Handkep/LEDController/KiCad/plots/LEDController__Assembly.pdf

1 | 2 | 3 | 4 | 5 | 6

A

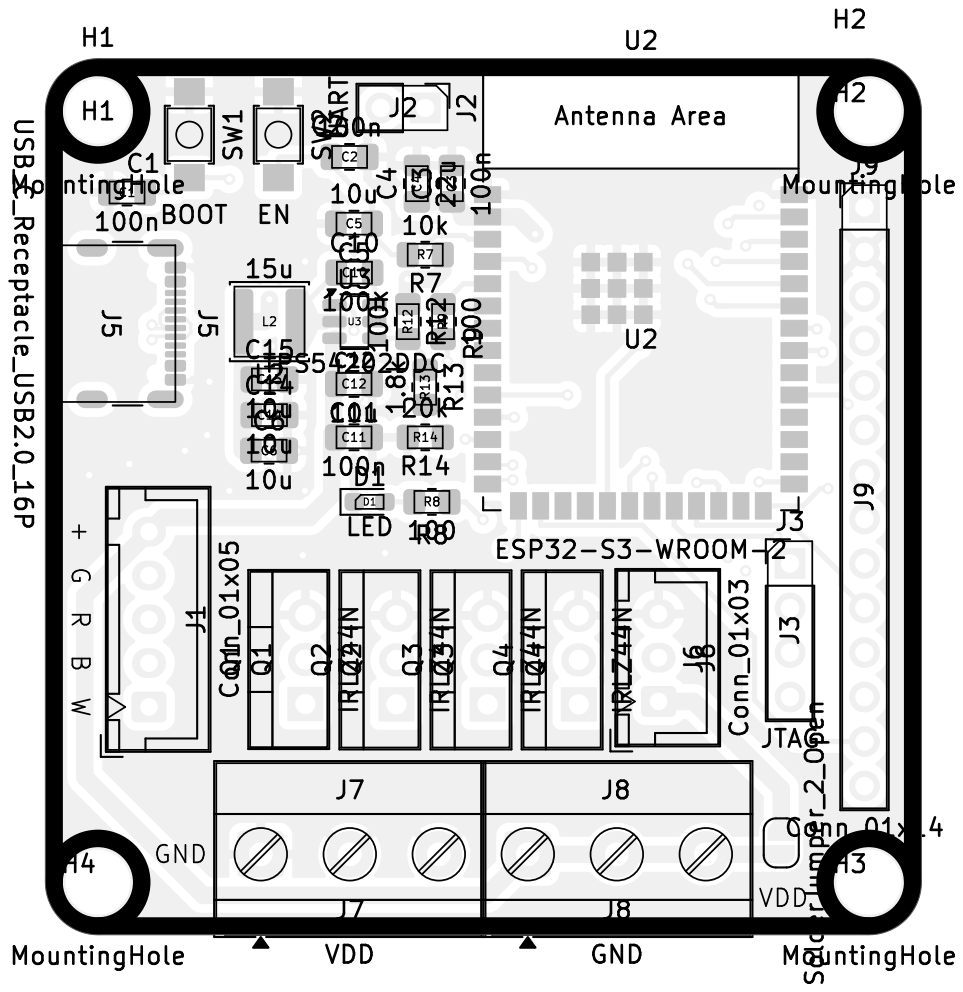
[picture p1: page 1]

A

A

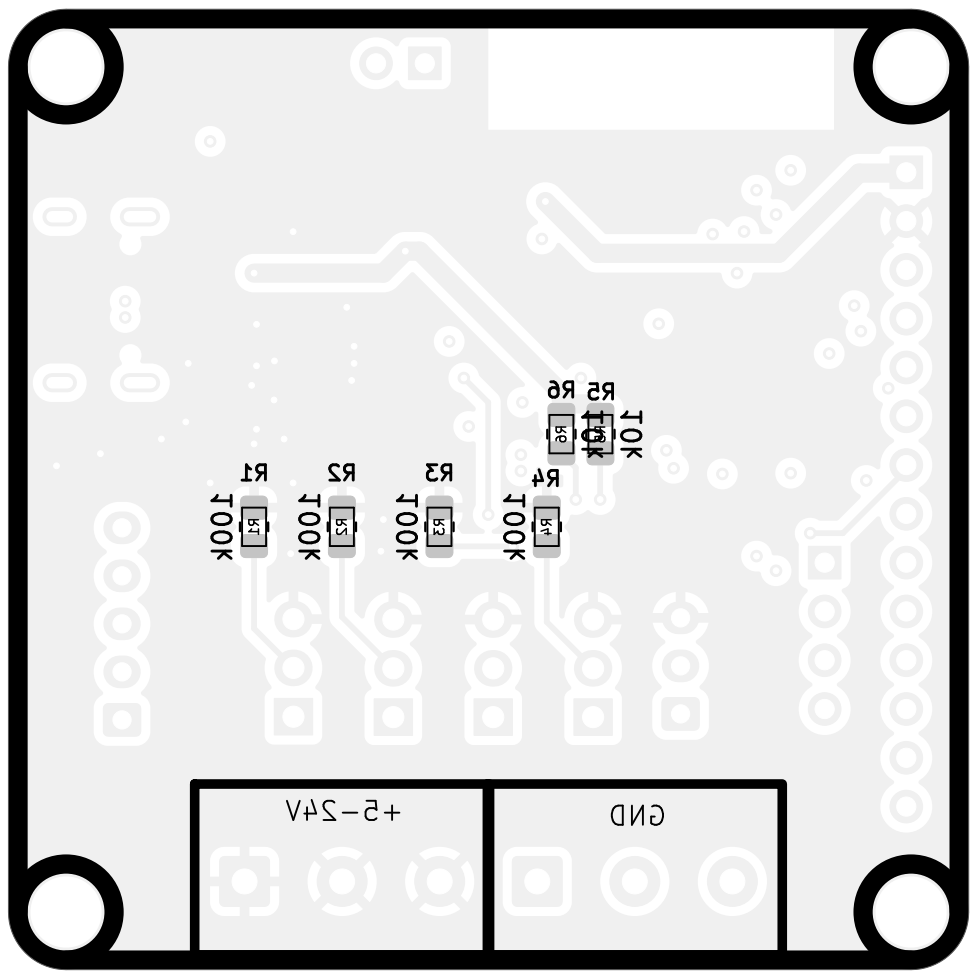
[picture p2: page 2]
D Date: 2025-05-27 KiCad; E.D.A. 9.0.2 Size: A4; Rev: 1; Id: /1 Title: LED Controller File: LEDController.kicad_pcb Sheet: Black; And; White; BOT Paulus; Handke Board2Pdf:; Black; BOT -; Page 2/6 ¹⁰kR5 100k

A

A

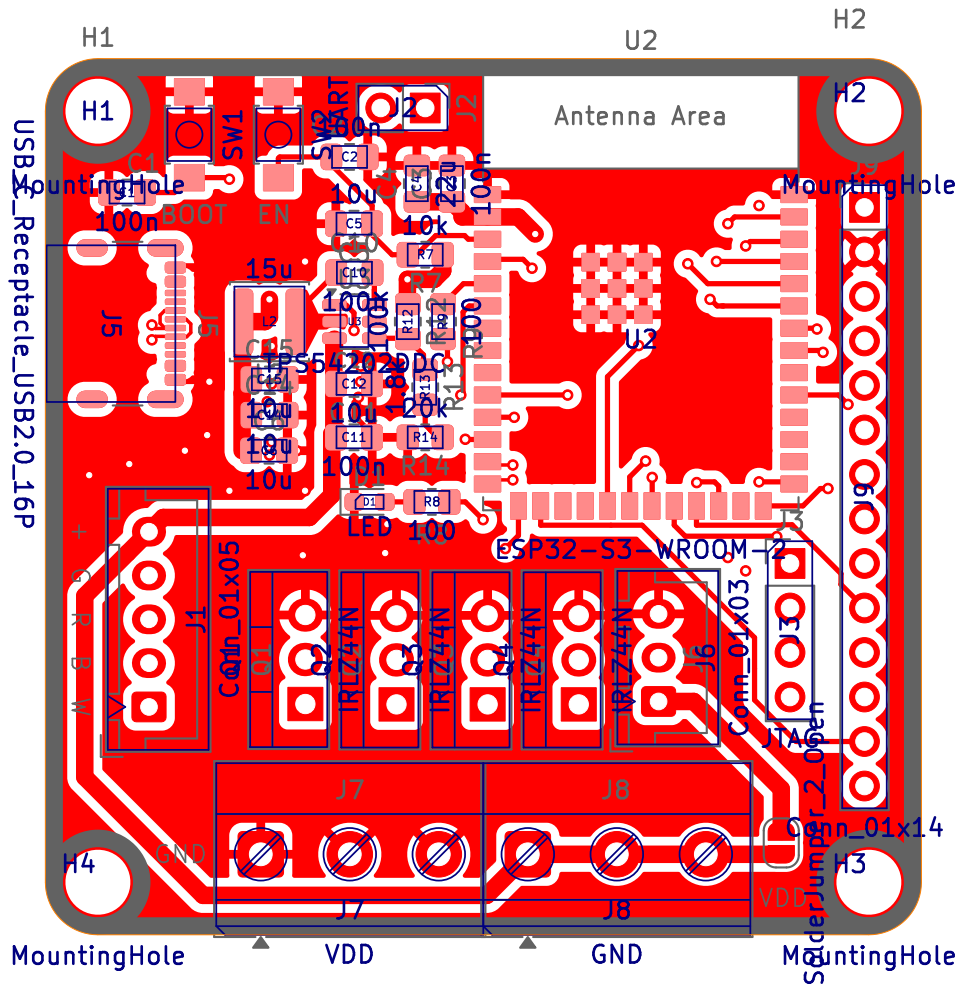
[picture p3: page 3]

A

A

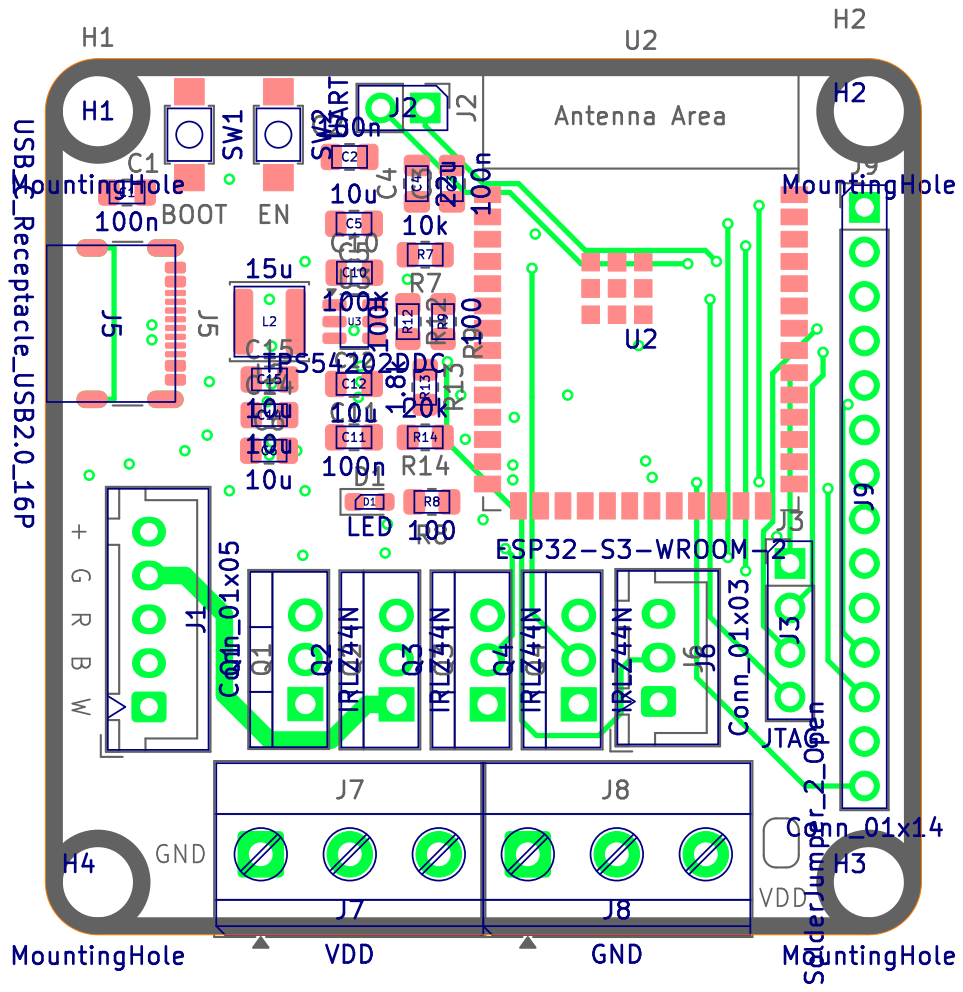
[picture p4: page 4]

A

A

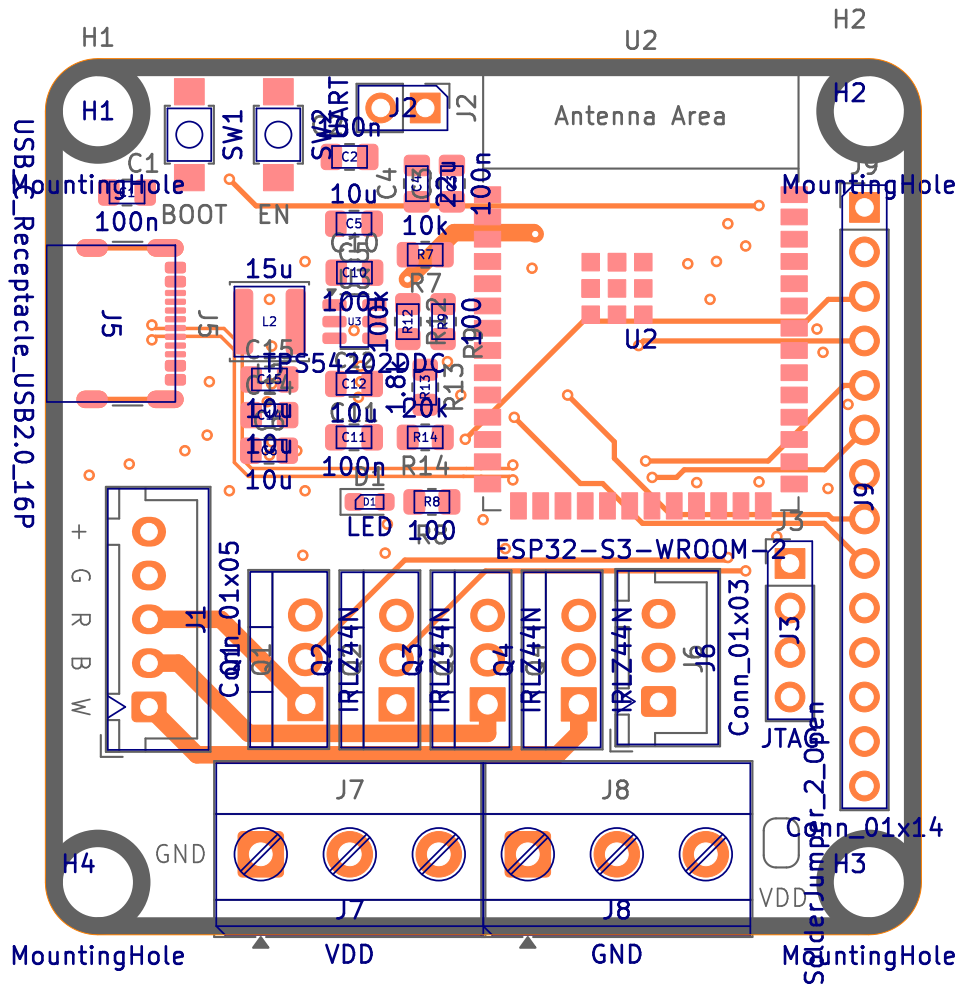
[picture p5: page 5]

A

A

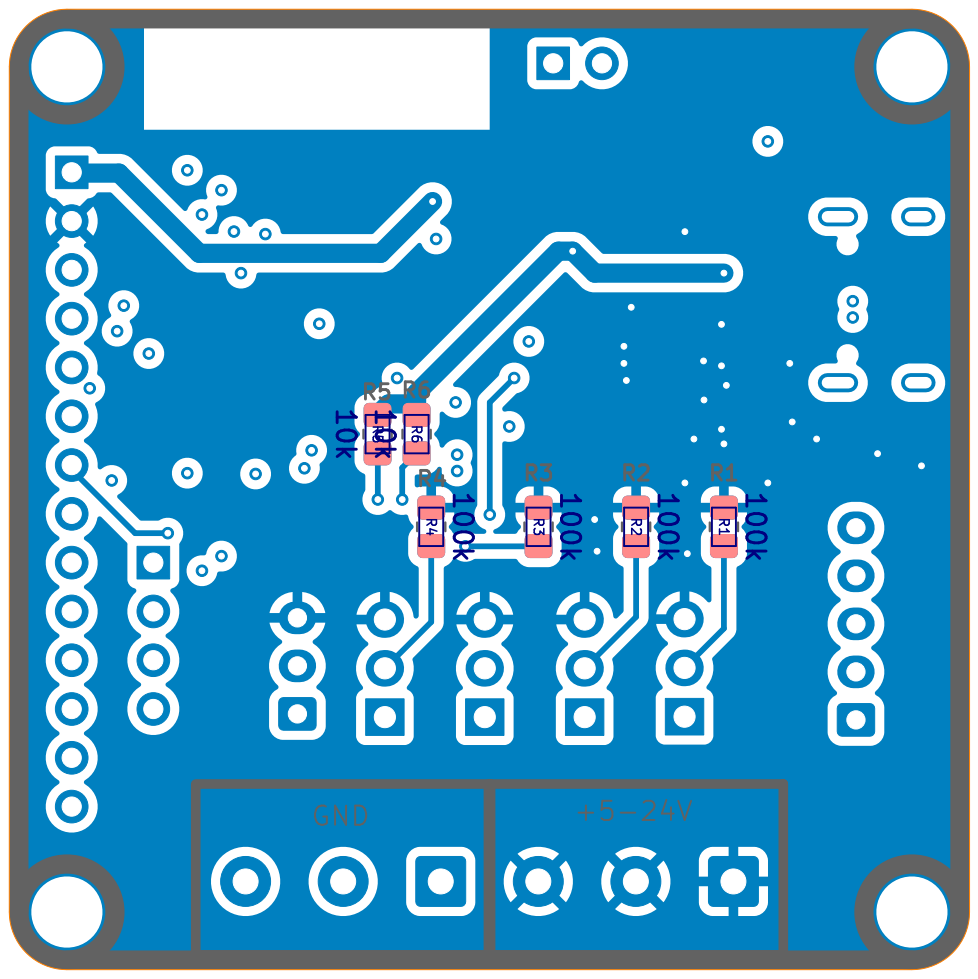
[picture p6: page 6]
GND; D Date: 2025-05-27 KiCad; E.D.A. 9.0.2 Size: A4; Rev: 1; Id: /1 Title: LED Controller File: LEDController.kicad_pcb Sheet: Colored; BOT Paulus; Handke Board2Pdf:; Colored; BOT -; Page 6/6 ¹⁰k
