Handkep/LEDController/KiCad/LEDController.pdf

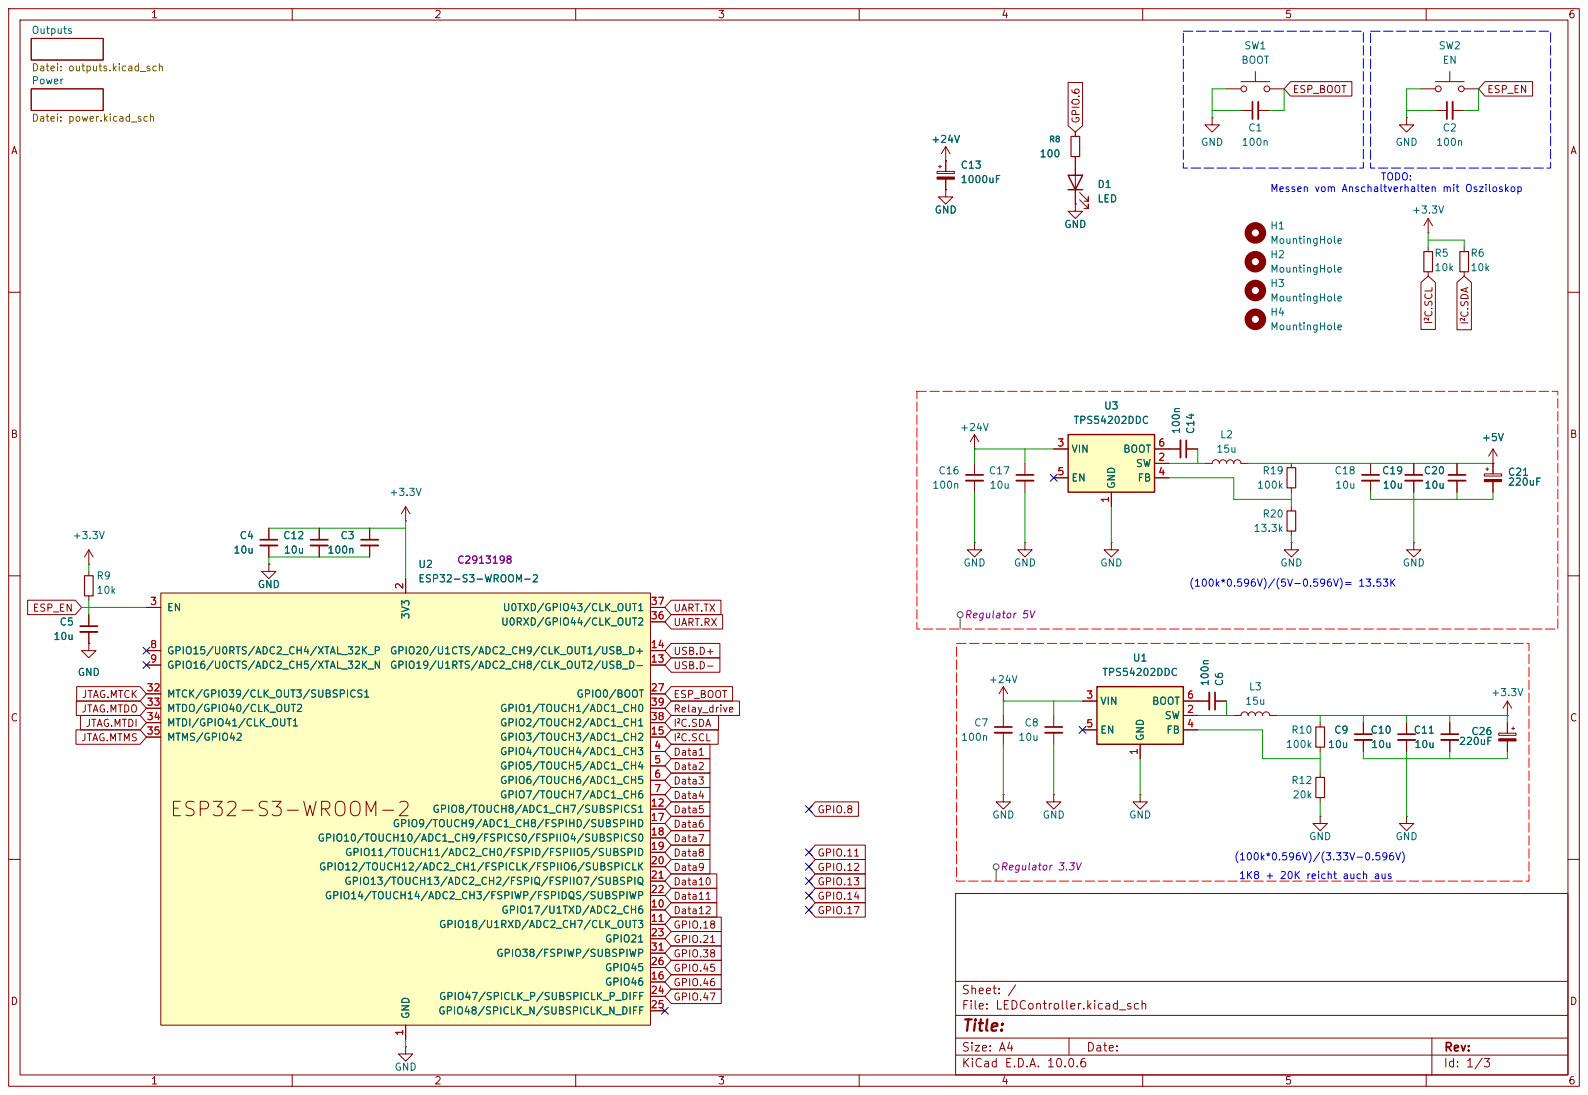
[picture p7: page 1]

TODO: Messen vom Anschaltverhalten mit Osziloskop

I2C.SDA GPIO.47 GPIO.45 GPIO.38 GPIO.46 GPIO.21 GPIO.18 UART.RX USB.D+

JTAG.MTDI JTAG.MTDO

Size: A4 | Rev:
KiCad E.D.A. 10.0.6 | Id: 1/3

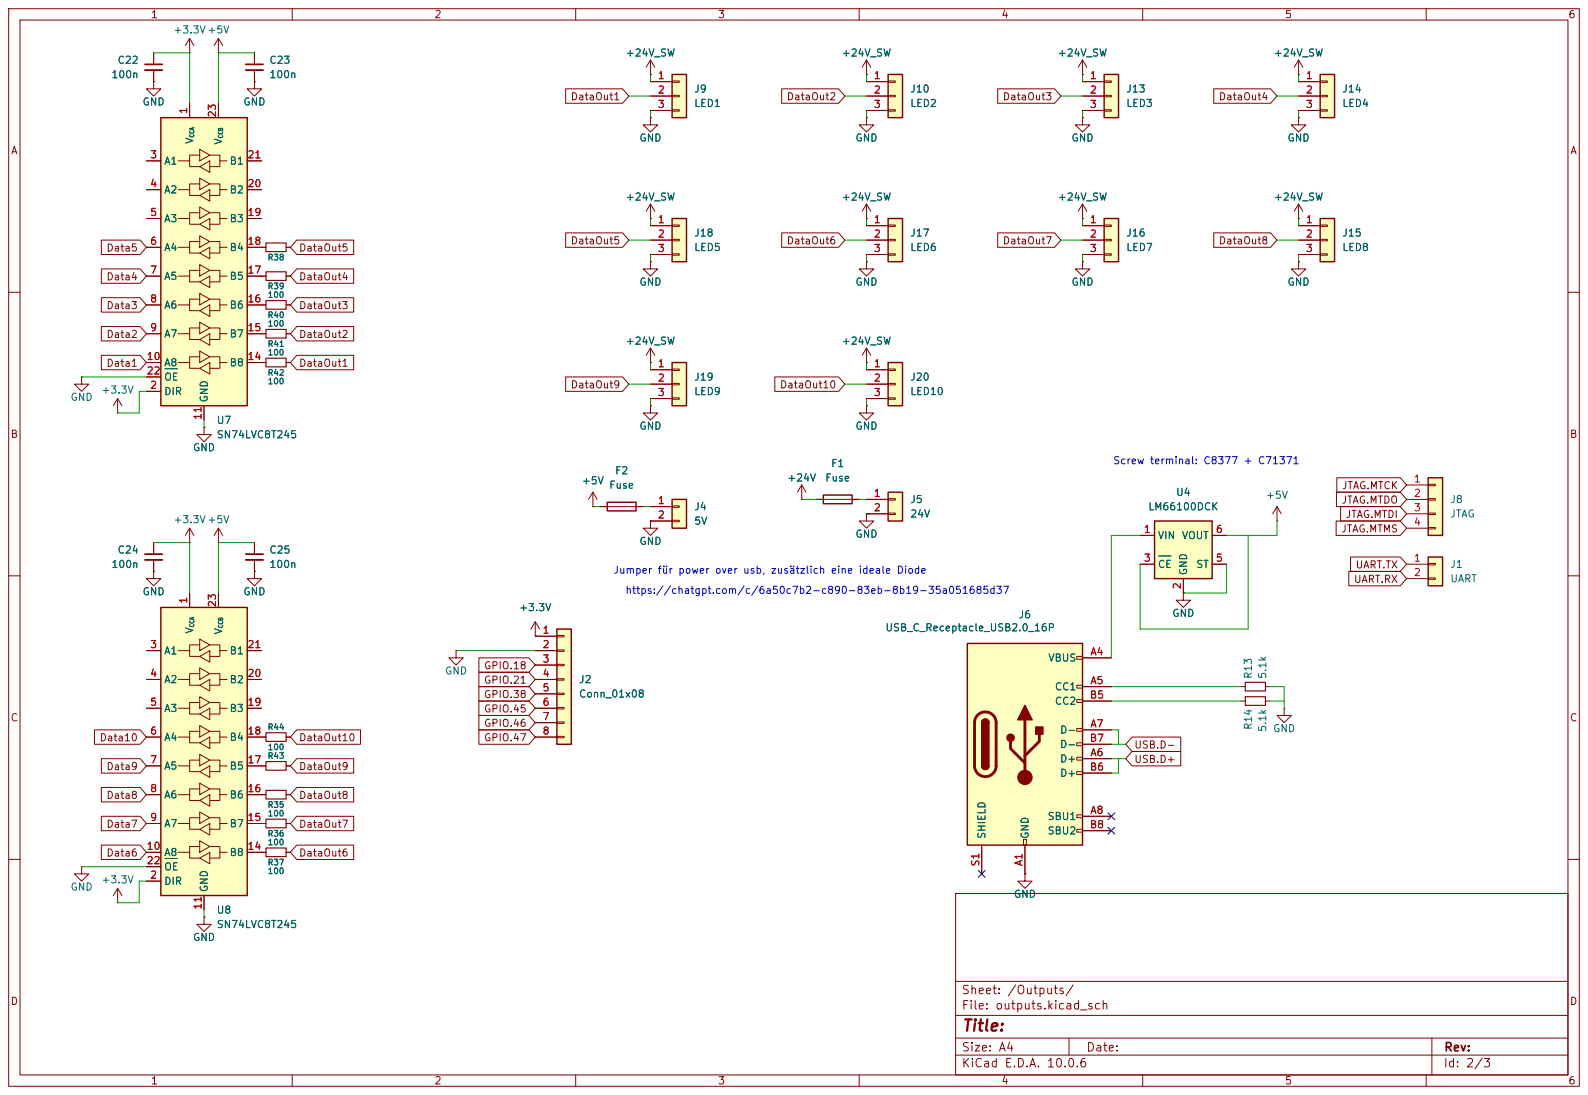
[picture p8: page 2]

JTAG.MTCK
JTAG.MTDO
JTAG.MTDI UART.TX

Jumper für power over usb, zusätzlich eine ideale Diode https://chatgpt.com/c/6a50c7b2-c890-83eb-8b19-35a051685d37

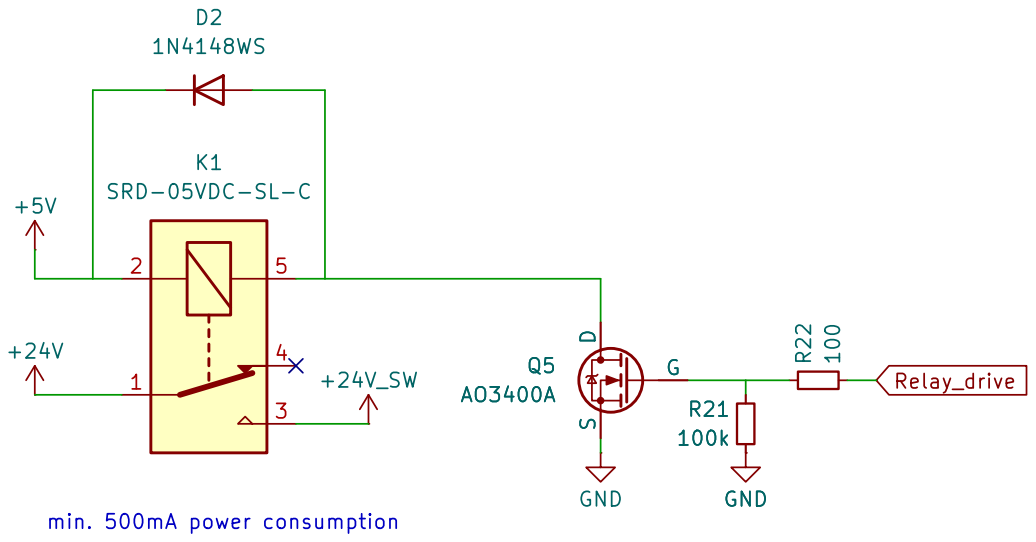
[picture p9: page 3]
