Handkep/LEDController/KiCad/LEDController.kicad_pcb

## KiCad design KiCad/LEDController.kicad_pcb (2026-10-28)

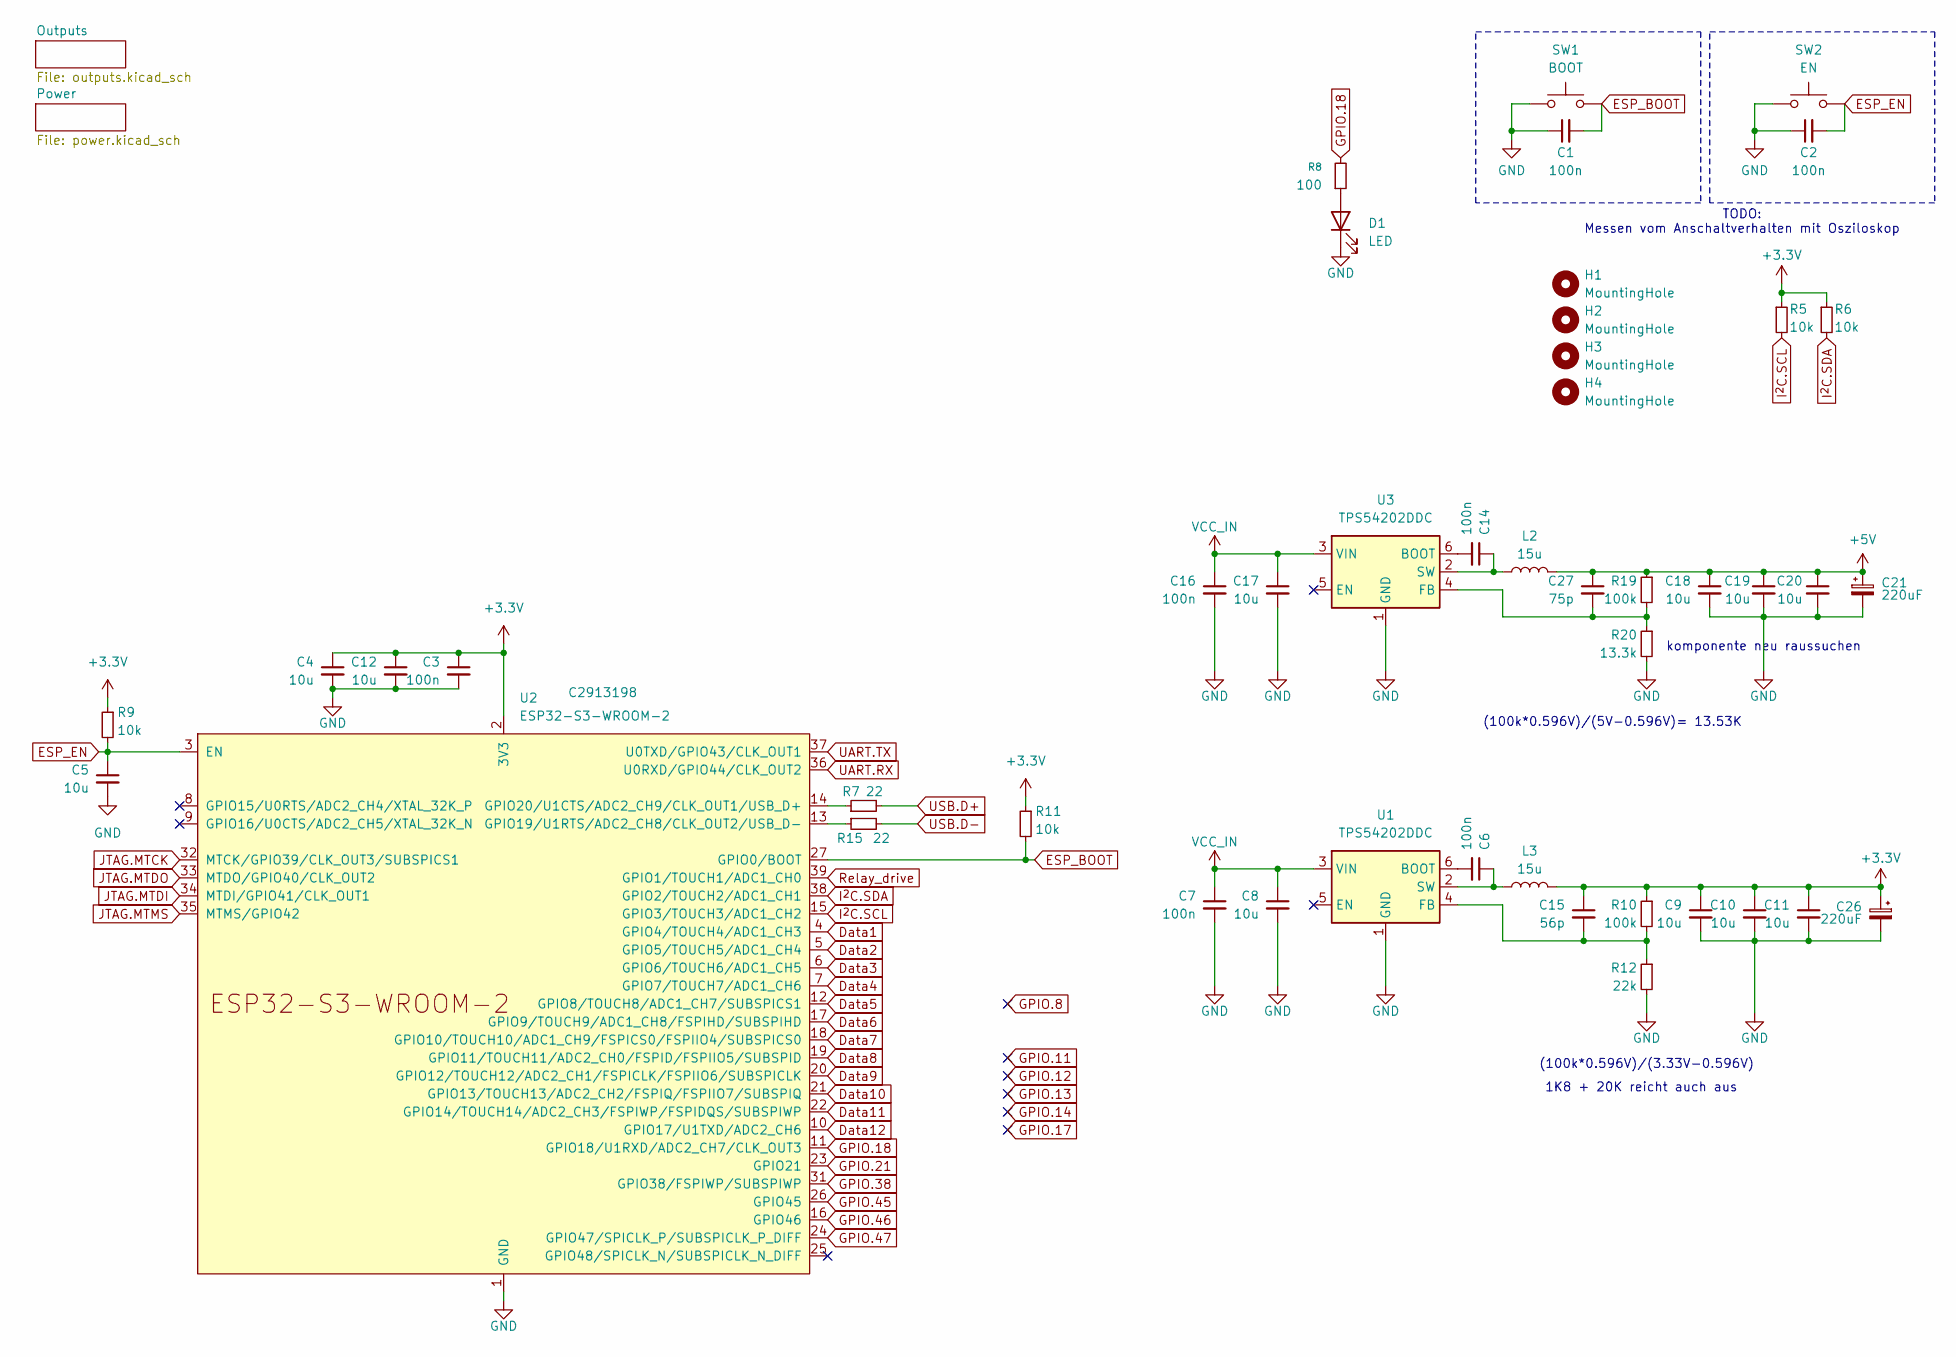
[picture p10: schematic LEDController.kicad_sch]

Parts:
C1, C2, C3, C6, C7, C14, C16: 100n; C_0805_2012Metric_Pad1.18x1.45mm_HandSolder; LCSC C5137467
C4, C5, C8, C9, C10, C11, C12, C17, C18, C19, C20: 10u; C_0805_2012Metric_Pad1.18x1.45mm_HandSolder; LCSC C33546007
C15: 56p; C_0805_2012Metric_Pad1.18x1.45mm_HandSolder
C21, C26: 220uF; CP_Radial_D8.0mm_P3.50mm; LCSC C107639
C27: 75p; C_0805_2012Metric_Pad1.18x1.45mm_HandSolder
D1: LED; LED_0603_1608Metric_Pad1.05x0.95mm_HandSolder; LCSC C7496818
H1, H2, H3, H4: MountingHole; MountingHole_3.2mm_M3
L2, L3: 15u; L_APV_APH0630; LCSC C5349699
R5, R6, R9, R11: 10k; R_0805_2012Metric_Pad1.20x1.40mm_HandSolder; LCSC C2930231
R7, R15: 22; R_0805_2012Metric_Pad1.20x1.40mm_HandSolder
R8: 100; R_0805_2012Metric_Pad1.20x1.40mm_HandSolder; LCSC C2907294
R10, R19: 100k; R_0805_2012Metric_Pad1.20x1.40mm_HandSolder; LCSC C3017875
R12: 22k; R_0805_2012Metric_Pad1.20x1.40mm_HandSolder; LCSC C2907015
R20: 13.3k; R_0805_2012Metric_Pad1.20x1.40mm_HandSolder; LCSC C3017875
SW1: BOOT; SHOU HAN TS342A2P-WZ; LCSC C557591
SW2: EN; SHOU HAN TS342A2P-WZ; LCSC C557591
U1, U3: TPS54202DDC; SOT-23-6; LCSC C191884
U2: ESP32-S3-WROOM-2; LCSC C2913198

Connections:
+3.3V: C3.1, C4.1, C9.1, C10.1, C11.1, C12.1, C15.1, C26.1, L3.2, R5.1, R6.1, R9.1, R10.1, R11.1, U2.2 (3V3); also elsewhere on the board
+5V: C18.1, C19.1, C20.1, C21.1, C27.1, L2.2, R19.1; also elsewhere on the board
Data1: U2.4 (GPIO4/TOUCH4/ADC1_CH3); also elsewhere on the board
Data2: U2.5 (GPIO5/TOUCH5/ADC1_CH4); also elsewhere on the board
Data3: U2.6 (GPIO6/TOUCH6/ADC1_CH5); also elsewhere on the board
Data4: U2.7 (GPIO7/TOUCH7/ADC1_CH6); also elsewhere on the board
Data5: U2.12 (GPIO8/TOUCH8/ADC1_CH7/SUBSPICS1); also elsewhere on the board
Data6: U2.17 (GPIO9/TOUCH9/ADC1_CH8/FSPIHD/SUBSPIHD); also elsewhere on the board
Data7: U2.18 (GPIO10/TOUCH10/ADC1_CH9/FSPICS0/FSPIIO4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); also elsewhere on the board
Data8: U2.19 (GPIO11/TOUCH11/ADC2_CH0/FSPID/FSPIIO5/S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); also elsewhere on the board
Data9: U2.20 (GPIO12/TOUCH12/ADC2_CH1/FSPICLK/FSPIIO6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); also elsewhere on the board
Data10: U2.21 (GPIO13/TOUCH13/ADC2_CH2/FSPIQ/FSPIIO7/S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); also elsewhere on the board
Data11: U2.22 (GPIO14/TOUCH14/ADC2_CH3/FSPIWP/FSPIDQS/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)
Data12: U2.10 (GPIO17/U1TXD/ADC2_CH6)
ESP_BOOT: C1.2, R11.2, SW1.2, U2.27 (GPIO0/BOOT)
ESP_EN: C2.2, C5.1, R9.2, SW2.2, U2.3 (EN)
GND: C1.1, C2.1, C3.2, C4.2, C5.2, C7.2, C8.2, C9.2, C10.2, C11.2, C12.2, C16.2, C17.2, C18.2, C19.2, C20.2, C21.2, C26.2, D1.1 (K), R12.2, R20.2, SW1.1, SW2.1, U1.1 (GND), U2.1 (GND), U2.40 (GND), U2.41 (GND), U3.1 (GND); also elsewhere on the board
GPIO.18: R8.2, U2.11 (GPIO18/U1RXD/ADC2_CH7/CLK_OUT3); also elsewhere on the board
GPIO.21: U2.23 (GPIO21); also elsewhere on the board
GPIO.38: U2.31 (GPIO38/FSPIWP/SUBSPIWP); also elsewhere on the board
GPIO.45: U2.26 (GPIO45); also elsewhere on the board
GPIO.46: U2.16 (GPIO46); also elsewhere on the board
GPIO.47: U2.24 (GPIO47/SPICLK_P/SUBSPICLK_P_DIFF); also elsewhere on the board
I^{2}C.SCL: R5.2, U2.15 (GPIO3/TOUCH3/ADC1_CH2)
I^{2}C.SDA: R6.2, U2.38 (GPIO2/TOUCH2/ADC1_CH1)
JTAG.MTCK: U2.32 (MTCK/GPIO39/CLK_OUT3/SUBSPICS1); also elsewhere on the board
JTAG.MTDI: U2.34 (MTDI/GPIO41/CLK_OUT1); also elsewhere on the board
JTAG.MTDO: U2.33 (MTDO/GPIO40/CLK_OUT2); also elsewhere on the board
JTAG.MTMS: U2.35 (MTMS/GPIO42); also elsewhere on the board
unnamed: D1.2 (A), R8.1
unnamed: C6.2, U1.6 (BOOT)
unnamed: C15.2, R10.2, R12.1, U1.4 (FB)
unnamed: C6.1, L3.1, U1.2 (SW)
unnamed: R15.1, U2.13 (GPIO19/U1RTS/ADC2_CH8/CLK_OUT2/USB_D-)
unnamed: R7.1, U2.14 (GPIO20/U1CTS/ADC2_CH9/CLK_OUT1/USB_D+)
unnamed: C14.2, U3.6 (BOOT)
unnamed: C27.2, R19.2, R20.1, U3.4 (FB)
unnamed: C14.1, L2.1, U3.2 (SW)
Relay_drive: U2.39 (GPIO1/TOUCH1/ADC1_CH0); also elsewhere on the board
UART.RX: U2.36 (U0RXD/GPIO44/CLK_OUT2); also elsewhere on the board
UART.TX: U2.37 (U0TXD/GPIO43/CLK_OUT1); also elsewhere on the board
USB.D+: R7.2; also elsewhere on the board
USB.D-: R15.2; also elsewhere on the board
VCC_IN: C7.1, C8.1, C16.1, C17.1, U1.3 (VIN), U3.3 (VIN); also elsewhere on the board

Notes on the sheet:
(100k*0.596V)/(5V-0.596V)= 13.53K
komponente neu raussuchen
(100k*0.596V)/(3.33V-0.596V)
1K8 + 20K reicht auch aus
TODO: Messen vom Anschaltverhalten mit Osziloskop

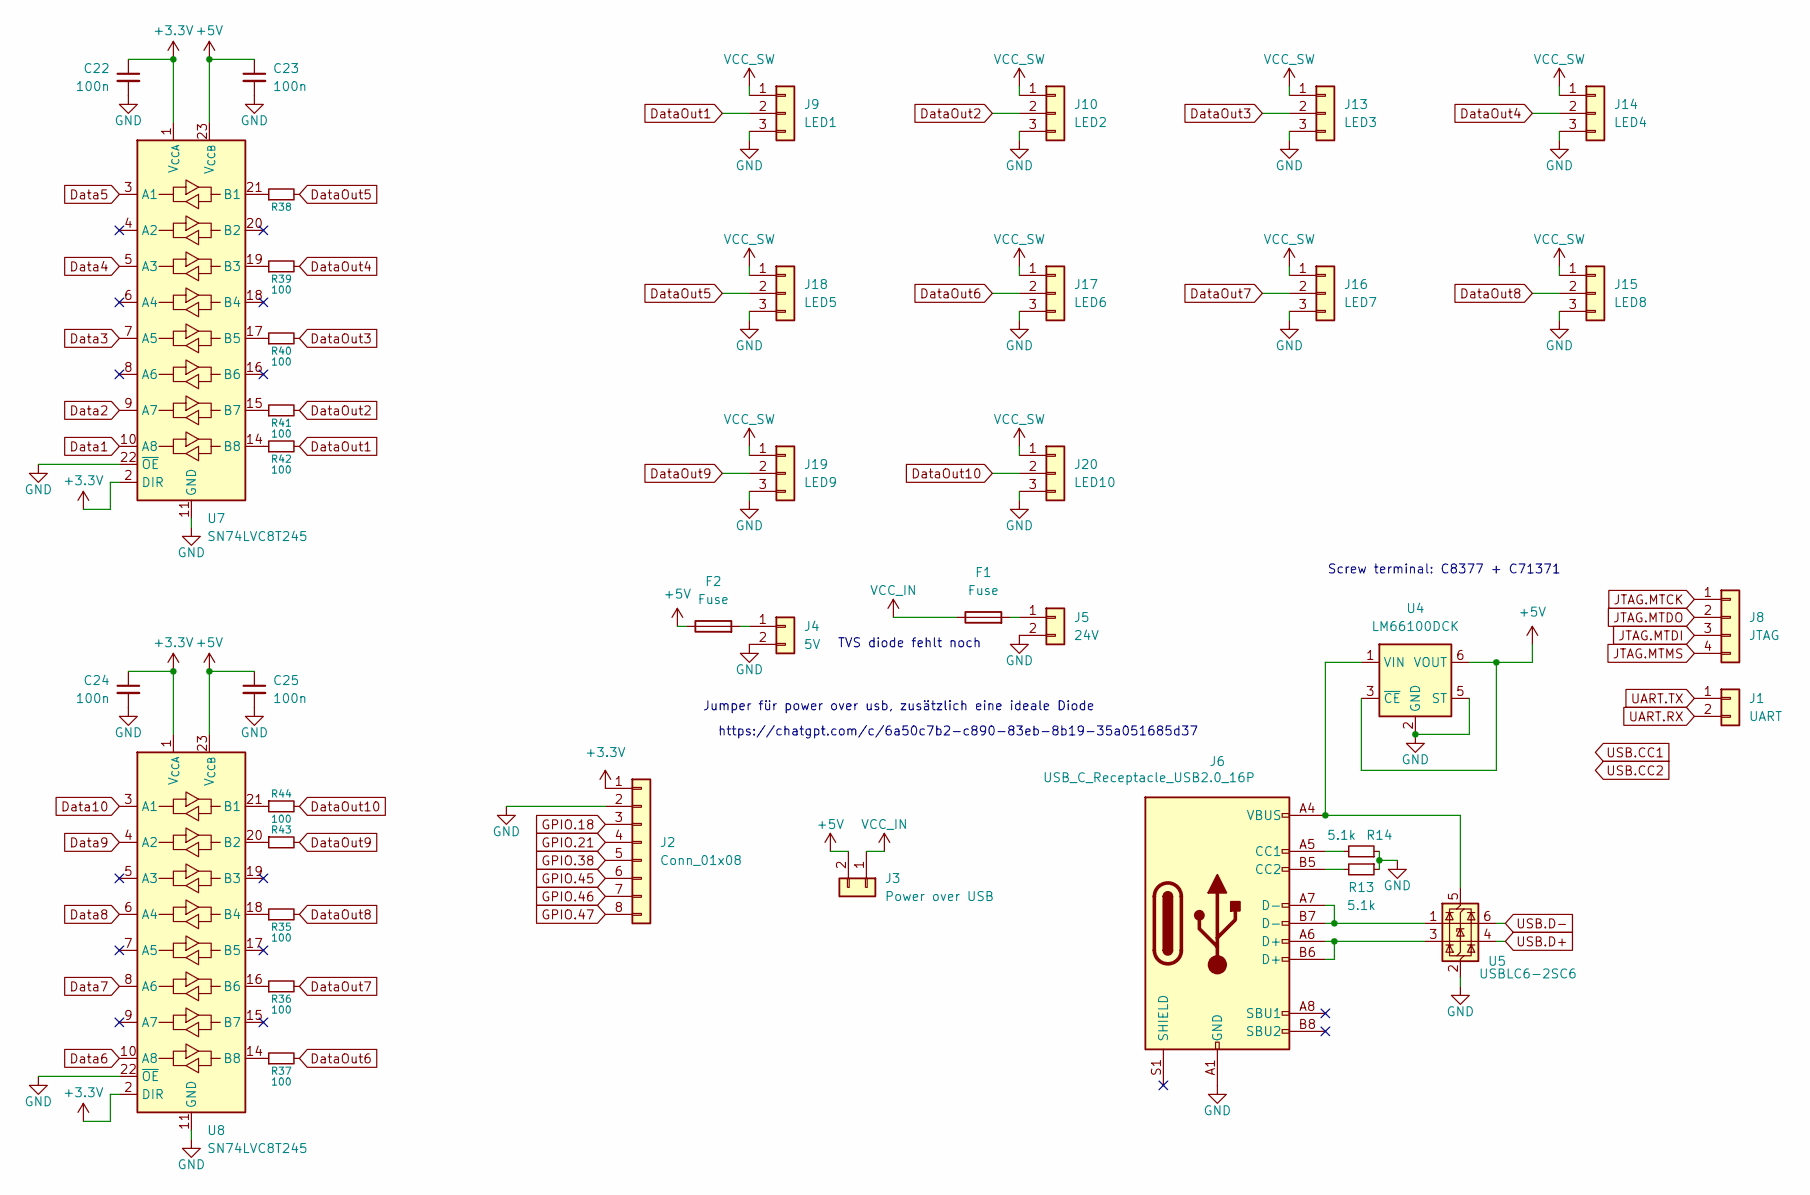
[picture p11: schematic outputs.kicad_sch]

Parts:
C22, C23, C24, C25: 100n; C_0805_2012Metric_Pad1.18x1.45mm_HandSolder; LCSC C5137467
F1, F2: Fuse; Fuseholder_Blade_Mini_Keystone_3568; LCSC C19727305
J1: UART; PinHeader_1x02_P2.54mm_Vertical
J2: Conn_01x08; PinHeader_1x08_P2.54mm_Vertical
J3: Power over USB; PinHeader_1x02_P2.54mm_Vertical
J4: 5V; CONN-TH_HB9500M-9.5-2P; LCSC C601239
J5: 24V; CONN-TH_HB9500M-9.5-2P; LCSC C601239
J6: USB_C_Receptacle_USB2.0_16P; USB_C_Receptacle_GCT_USB4105-xx-A_16P_TopMnt_Horizontal; LCSC C2765186
J8: JTAG; PinHeader_1x04_P2.54mm_Vertical
J9: LED1; CONN-TH_3P-P5.08_WJ2EDGRC-5.08-3P; LCSC C8377
J10: LED2; CONN-TH_3P-P5.08_WJ2EDGRC-5.08-3P; LCSC C8377
J13: LED3; CONN-TH_3P-P5.08_WJ2EDGRC-5.08-3P; LCSC C8377
J14: LED4; CONN-TH_3P-P5.08_WJ2EDGRC-5.08-3P; LCSC C8377
J15: LED8; CONN-TH_3P-P5.08_WJ2EDGRC-5.08-3P; LCSC C8377
J16: LED7; CONN-TH_3P-P5.08_WJ2EDGRC-5.08-3P; LCSC C8377
J17: LED6; CONN-TH_3P-P5.08_WJ2EDGRC-5.08-3P; LCSC C8377
J18: LED5; CONN-TH_3P-P5.08_WJ2EDGRC-5.08-3P; LCSC C8377
J19: LED9; CONN-TH_3P-P5.08_WJ2EDGRC-5.08-3P; LCSC C8377
J20: LED10; CONN-TH_3P-P5.08_WJ2EDGRC-5.08-3P; LCSC C8377
R13, R14: 5.1k; R_0805_2012Metric_Pad1.20x1.40mm_HandSolder; LCSC C2930296
R35, R36, R37, R38, R39, R40, R41, R42, R43, R44: 100; R_0805_2012Metric_Pad1.20x1.40mm_HandSolder; LCSC C2907294
U4: LM66100DCK; SOT-363_SC-70-6; LCSC C2869734
U5: USBLC6-2SC6; SOT-23-6; LCSC C21713975
U7, U8: SN74LVC8T245; TSSOP-24_4.4x7.8mm_P0.65mm; LCSC C27643

Connections:
+3.3V: C22.1, C24.1, J2.1, U7.1 (V_{CCA}), U7.2 (DIR), U8.1 (V_{CCA}), U8.2 (DIR); also elsewhere on the board
+5V: C23.1, C25.1, F2.1, J3.2, U4.3 (~CE), U4.6 (VOUT), U7.23 (V_{CCB}), U7.24 (V_{CCB}), U8.23 (V_{CCB}), U8.24 (V_{CCB}); also elsewhere on the board
Data1: U7.10 (A8); also elsewhere on the board
Data2: U7.9 (A7); also elsewhere on the board
Data3: U7.7 (A5); also elsewhere on the board
Data4: U7.5 (A3); also elsewhere on the board
Data5: U7.3 (A1); also elsewhere on the board
Data6: U8.10 (A8); also elsewhere on the board
Data7: U8.8 (A6); also elsewhere on the board
Data8: U8.6 (A4); also elsewhere on the board
Data9: U8.4 (A2); also elsewhere on the board
Data10: U8.3 (A1); also elsewhere on the board
DataOut1: J9.2, R42.2
DataOut2: J10.2, R41.2
DataOut3: J13.2, R40.2
DataOut4: J14.2, R39.2
DataOut5: J18.2, R38.2
DataOut6: J17.2, R37.2
DataOut7: J16.2, R36.2
DataOut8: J15.2, R35.2
DataOut9: J19.2, R43.2
DataOut10: J20.2, R44.2
GND: C22.2, C23.2, C24.2, C25.2, J2.2, J4.2, J5.2, J6.A1 (GND), J6.A12 (GND), J6.B1 (GND), J6.B12 (GND), J9.3, J10.3, J13.3, J14.3, J15.3, J16.3, J17.3, J18.3, J19.3, J20.3, R13.1, R14.1, U4.2 (GND), U4.5 (ST), U5.2 (GND), U7.11 (GND), U7.12 (GND), U7.13 (GND), U7.22 (~OE), U8.11 (GND), U8.12 (GND), U8.13 (GND), U8.22 (~OE); also elsewhere on the board
GPIO.18: J2.3; also elsewhere on the board
GPIO.21: J2.4; also elsewhere on the board
GPIO.38: J2.5; also elsewhere on the board
GPIO.45: J2.6; also elsewhere on the board
GPIO.46: J2.7; also elsewhere on the board
GPIO.47: J2.8; also elsewhere on the board
JTAG.MTCK: J8.1; also elsewhere on the board
JTAG.MTDI: J8.3; also elsewhere on the board
JTAG.MTDO: J8.2; also elsewhere on the board
JTAG.MTMS: J8.4; also elsewhere on the board
unnamed: F2.2, J4.1
unnamed: F1.2, J5.1
unnamed: J6.A5 (CC1), R14.2
unnamed: J6.B5 (CC2), R13.2
unnamed: J6.A6 (D+), J6.B6 (D+), U5.3 (I/O2)
unnamed: J6.A7 (D-), J6.B7 (D-), U5.1 (I/O1)
unnamed: J6.A4 (VBUS), J6.A9 (VBUS), J6.B4 (VBUS), J6.B9 (VBUS), U4.1 (VIN), U5.5 (VBUS)
unnamed: R38.1, U7.21 (B1)
unnamed: R39.1, U7.19 (B3)
unnamed: R40.1, U7.17 (B5)
unnamed: R41.1, U7.15 (B7)
unnamed: R42.1, U7.14 (B8)
unnamed: R44.1, U8.21 (B1)
unnamed: R43.1, U8.20 (B2)
unnamed: R35.1, U8.18 (B4)
unnamed: R36.1, U8.16 (B6)
unnamed: R37.1, U8.14 (B8)
UART.RX: J1.2; also elsewhere on the board
UART.TX: J1.1; also elsewhere on the board
USB.D+: U5.4 (I/O2); also elsewhere on the board
USB.D-: U5.6 (I/O1); also elsewhere on the board
VCC_IN: F1.1, J3.1; also elsewhere on the board
VCC_SW: J9.1, J10.1, J13.1, J14.1, J15.1, J16.1, J17.1, J18.1, J19.1, J20.1; also elsewhere on the board

Notes on the sheet:
TVS diode fehlt noch
https://chatgpt.com/c/6a50c7b2-c890-83eb-8b19-35a051685d37
Jumper für power over usb, zusätzlich eine ideale Diode
Screw terminal: C8377 + C71371

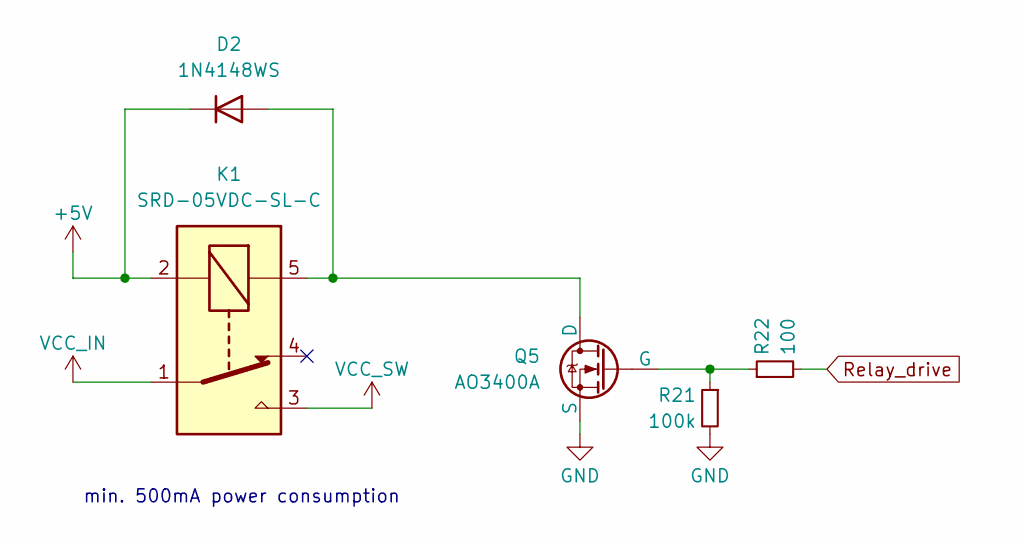
[picture p12: schematic power.kicad_sch]

Parts:
D2: 1N4148WS; D_SOD-323; LCSC C917030
K1: SRD-05VDC-SL-C; Relay_SPDT_SANYOU_SRD_Series_Form_C; LCSC C35449
Q5: AO3400A; SOT-23; LCSC C20917
R21: 100k; R_0805_2012Metric_Pad1.20x1.40mm_HandSolder; LCSC C3017875
R22: 100; R_0805_2012Metric_Pad1.20x1.40mm_HandSolder; LCSC C2907294

Connections:
+5V: D2.1 (K), K1.2; also elsewhere on the board
GND: Q5.3 (S), R21.2; also elsewhere on the board
unnamed: D2.2 (A), K1.5, Q5.1 (D)
unnamed: Q5.2 (G), R21.1, R22.1
Relay_drive: R22.2; also elsewhere on the board
VCC_IN: K1.1; also elsewhere on the board
VCC_SW: K1.3; also elsewhere on the board

Notes on the sheet:
min. 500mA power consumption

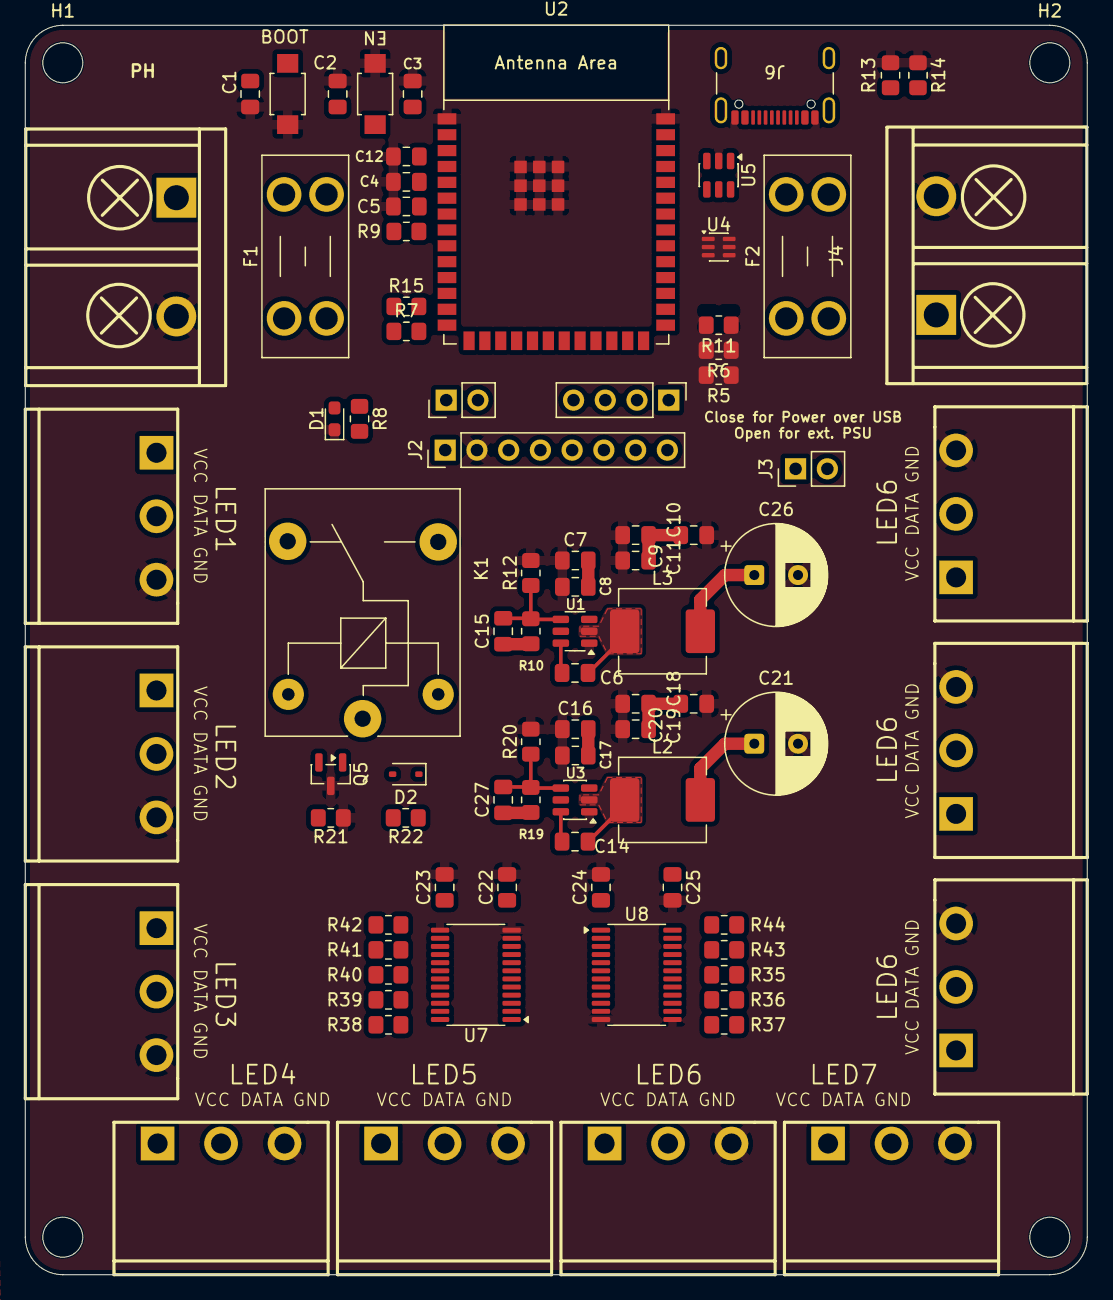
[picture p13: board LEDController.kicad_pcb from above]

Board: 4 copper layers, 85.0 x 100.0 mm, 89 parts (0 on the bottom side), 72 nets.
