Handkep/LEDController/KiCad/LEDController4L.kicad_pcb

## KiCad design KiCad/LEDController4L.kicad_pcb (2025-05-27)

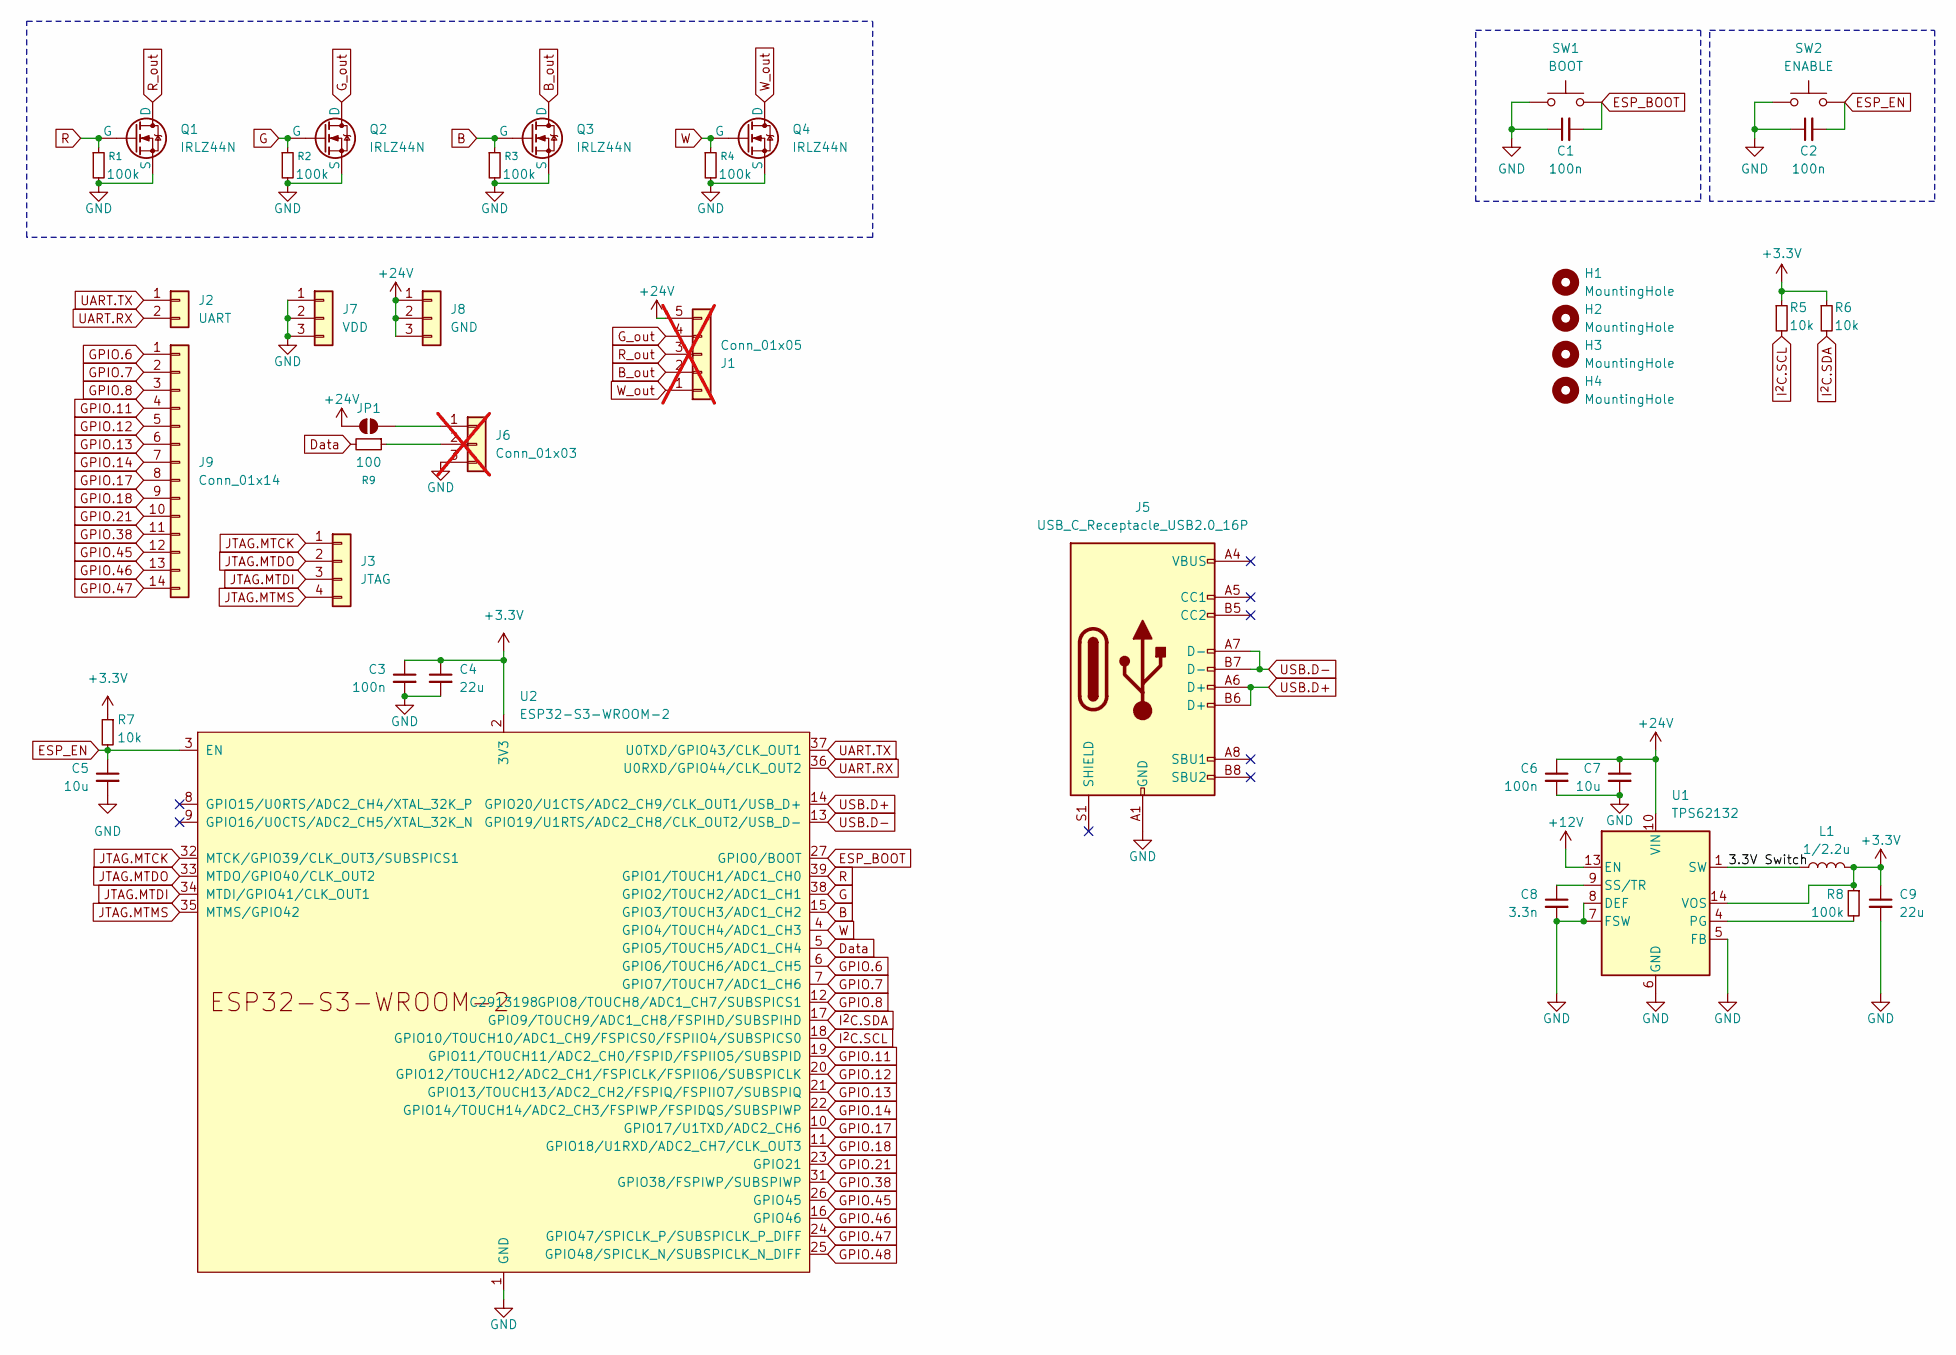
[picture p14: schematic LEDController4L.kicad_sch]

Parts:
C1, C2, C3, C6: 100n; C_0805_2012Metric_Pad1.18x1.45mm_HandSolder
C4, C9: 22u; C_0805_2012Metric_Pad1.18x1.45mm_HandSolder
C5, C7: 10u; C_1210_3225Metric_Pad1.33x2.70mm_HandSolder
C8: 3.3n; C_0805_2012Metric_Pad1.18x1.45mm_HandSolder
H1, H2, H3, H4: MountingHole; MountingHole_3.2mm_M3
J1: Conn_01x05; JST_XH_B5B-XH-A_1x05_P2.50mm_Vertical; not fitted
J2: UART; PinHeader_1x02_P2.54mm_Vertical
J3: JTAG; PinHeader_1x04_P2.54mm_Vertical
J5: USB_C_Receptacle_USB2.0_16P; USB_C_Receptacle_GCT_USB4105-xx-A_16P_TopMnt_Horizontal; LCSC C2765186
J6: Conn_01x03; JST_XH_B3B-XH-A_1x03_P2.50mm_Vertical; not fitted
J7: VDD; TerminalBlock_Phoenix_MKDS-1,5-3-5.08_1x03_P5.08mm_Horizont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
J8: GND; TerminalBlock_Phoenix_MKDS-1,5-3-5.08_1x03_P5.08mm_Horizont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
J9: Conn_01x14; PinHeader_1x14_P2.54mm_Vertical
JP1: SolderJumper_2_Open; SolderJumper-2_P1.3mm_Open_RoundedPad1.0x1.5mm
L1: 1/2.2u; L_APV_ANR4026
Q1, Q2, Q3, Q4: IRLZ44N; TO-220-3_Vertical; LCSC C42370423
R1, R2, R3, R4, R8: 100k; R_0805_2012Metric_Pad1.20x1.40mm_HandSolder; LCSC C3017875
R5, R6, R7: 10k; R_0805_2012Metric_Pad1.20x1.40mm_HandSolder; LCSC C2930231
R9: 100; R_0805_2012Metric_Pad1.20x1.40mm_HandSolder; LCSC C2907294
SW1: BOOT; SHOU HAN TS342A2P-WZ; LCSC C557591
SW2: ENABLE; SHOU HAN TS342A2P-WZ; LCSC C557591
U1: TPS62132; VQFN-16-1EP_3x3mm_P0.5mm_EP1.68x1.68mm_ThermalVias; LCSC C81563
U2: ESP32-S3-WROOM-2; LCSC C2913198

Connections:
+3.3V: C3.1, C4.1, C9.1, L1.2, R5.1, R6.1, R7.1, R8.1, U1.14 (VOS), U2.2 (3V3)
+12V: U1.13 (EN)
+24V: C6.1, C7.1, J1.5, J8.1, J8.2, J8.3, JP1.1 (A), U1.10 (VIN), U1.11 (VIN), U1.12 (VIN)
/3.3V Switch: L1.1, U1.1 (SW), U1.2 (SW), U1.3 (SW)
B: Q3.2 (G), R3.1, U2.15 (GPIO3/TOUCH3/ADC1_CH2)
B_out: J1.2, Q3.1 (D)
Data: R9.2, U2.5 (GPIO5/TOUCH5/ADC1_CH4)
ESP_BOOT: C1.2, SW1.2, U2.27 (GPIO0/BOOT)
ESP_EN: C2.2, C5.1, R7.2, SW2.2, U2.3 (EN)
G: Q2.2 (G), R2.1, U2.38 (GPIO2/TOUCH2/ADC1_CH1)
GND: C1.1, C2.1, C3.2, C4.2, C5.2, C6.2, C7.2, C8.2, C9.2, J5.A1 (GND), J5.A12 (GND), J5.B1 (GND), J5.B12 (GND), J6.3, J7.1, J7.2, J7.3, Q1.3 (S), Q2.3 (S), Q3.3 (S), Q4.3 (S), R1.2, R2.2, R3.2, R4.2, SW1.1, SW2.1, U1.5 (FB), U1.6 (GND), U1.7 (FSW), U1.8 (DEF), U1.15 (GND), U1.16 (GND), U1.17 (GND), U2.1 (GND), U2.40 (GND), U2.41 (GND)
GPIO.6: J9.1, U2.6 (GPIO6/TOUCH6/ADC1_CH5)
GPIO.7: J9.2, U2.7 (GPIO7/TOUCH7/ADC1_CH6)
GPIO.8: J9.3, U2.12 (GPIO8/TOUCH8/ADC1_CH7/SUBSPICS1)
GPIO.11: J9.4, U2.19 (GPIO11/TOUCH11/ADC2_CH0/FSPID/FSPIIO5/S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)
GPIO.12: J9.5, U2.20 (GPIO12/TOUCH12/ADC2_CH1/FSPICLK/FSPIIO6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)
GPIO.13: J9.6, U2.21 (GPIO13/TOUCH13/ADC2_CH2/FSPIQ/FSPIIO7/S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)
GPIO.14: J9.7, U2.22 (GPIO14/TOUCH14/ADC2_CH3/FSPIWP/FSPIDQS/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)
GPIO.17: J9.8, U2.10 (GPIO17/U1TXD/ADC2_CH6)
GPIO.18: J9.9, U2.11 (GPIO18/U1RXD/ADC2_CH7/CLK_OUT3)
GPIO.21: J9.10, U2.23 (GPIO21)
GPIO.38: J9.11, U2.31 (GPIO38/FSPIWP/SUBSPIWP)
GPIO.45: J9.12, U2.26 (GPIO45)
GPIO.46: J9.13, U2.16 (GPIO46)
GPIO.47: J9.14, U2.24 (GPIO47/SPICLK_P/SUBSPICLK_P_DIFF)
GPIO.48: U2.25 (GPIO48/SPICLK_N/SUBSPICLK_N_DIFF)
G_out: J1.4, Q2.1 (D)
I^{2}C.SCL: R5.2, U2.18 (GPIO10/TOUCH10/ADC1_CH9/FSPICS0/FSPIIO4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)
I^{2}C.SDA: R6.2, U2.17 (GPIO9/TOUCH9/ADC1_CH8/FSPIHD/SUBSPIHD)
JTAG.MTCK: J3.1, U2.32 (MTCK/GPIO39/CLK_OUT3/SUBSPICS1)
JTAG.MTDI: J3.3, U2.34 (MTDI/GPIO41/CLK_OUT1)
JTAG.MTDO: J3.2, U2.33 (MTDO/GPIO40/CLK_OUT2)
JTAG.MTMS: J3.4, U2.35 (MTMS/GPIO42)
unnamed: J6.1, JP1.2 (B)
unnamed: J6.2, R9.1
unnamed: R8.2, U1.4 (PG)
unnamed: C8.1, U1.9 (SS/TR)
R: Q1.2 (G), R1.1, U2.39 (GPIO1/TOUCH1/ADC1_CH0)
R_out: J1.3, Q1.1 (D)
UART.RX: J2.2, U2.36 (U0RXD/GPIO44/CLK_OUT2)
UART.TX: J2.1, U2.37 (U0TXD/GPIO43/CLK_OUT1)
USB.D+: J5.A6 (D+), J5.B6 (D+), U2.14 (GPIO20/U1CTS/ADC2_CH9/CLK_OUT1/USB_D+)
USB.D-: J5.A7 (D-), J5.B7 (D-), U2.13 (GPIO19/U1RTS/ADC2_CH8/CLK_OUT2/USB_D-)
W: Q4.2 (G), R4.1, U2.4 (GPIO4/TOUCH4/ADC1_CH3)
W_out: J1.1, Q4.1 (D)

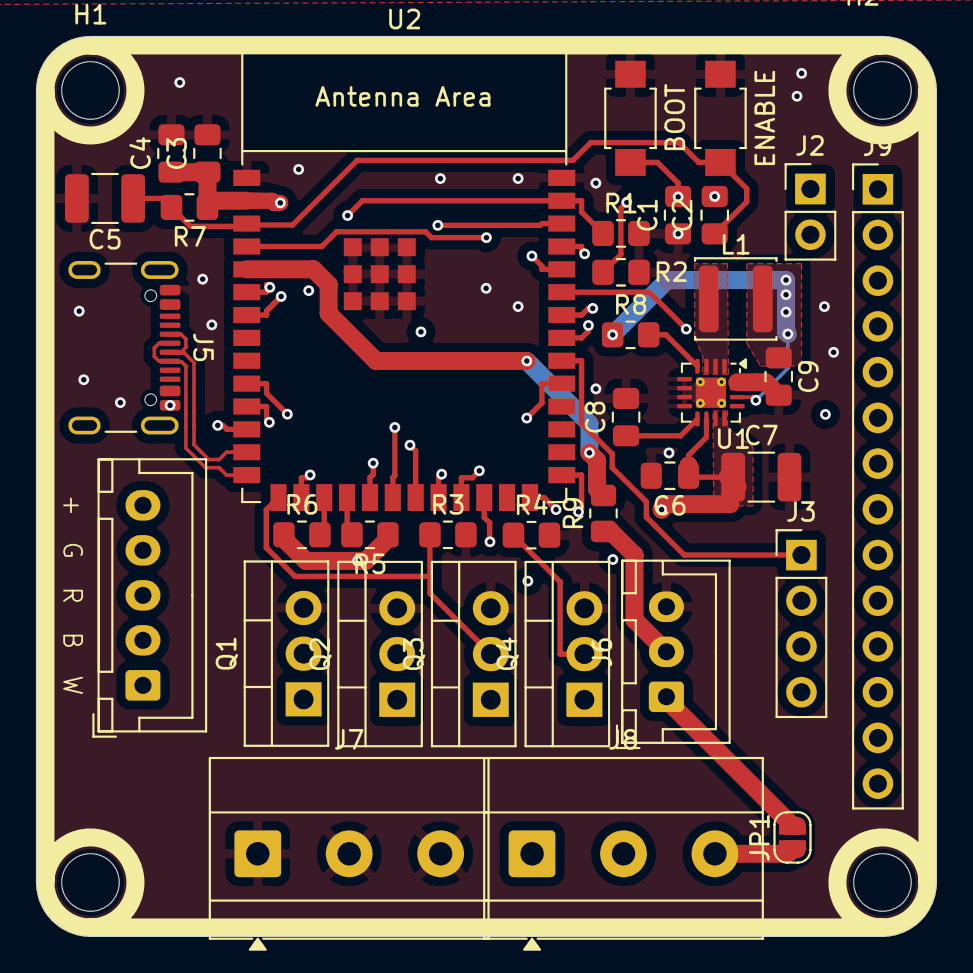
[picture p15: board LEDController4L.kicad_pcb from above]

Board: 4 copper layers, 50.0 x 50.0 mm, 40 parts (0 on the bottom side), 43 nets.
