Handkep/LEDController/(commit log)

2025-05-26 place components
    [LEDController.kicad_pcb, LEDController.kicad_sch]
2025-05-26 start routing
    [LEDController.kicad_pcb, LEDController.kicad_sch]
2025-05-26 add aditional header
    [LEDController.kicad_pcb, LEDController.kicad_sch]
2025-05-27 add kikit board2pdf, add some headers, route
    [LEDController-CuBottom.gbr, LEDController-CuTop.gbr, LEDController-EdgeCuts.gbr, LEDController-MaskBottom.gbr, LEDController-MaskTop.gbr, LEDController-NPTH.drl, LEDController-PTH.drl, LEDController-PasteBottom.gbr]
2025-05-27 convert to 4 layer pcb
    [LEDController4L.kicad_pcb, LEDController4L.kicad_sch, panel.kicad_pcb]
2025-05-27 add different buck converter
    [LEDController.kicad_pcb, LEDController.kicad_sch]
2025-05-30 rearrange again, route
    [LEDController.kicad_pcb, LEDController.kicad_sch]
2025-05-30 add led
    [LEDController.kicad_pcb, LEDController.kicad_sch]
2025-06-03 jlcpcb order
    [LEDController.kicad_pcb, LEDController.kicad_sch, panel.kicad_pcb]
2025-09-28 add mains power
    [LEDController.kicad_sch, untitled.kicad_sch]
2026-01-16 add 5v buck converter
    [AC_Power.kicad_sch, LEDController.kicad_pcb, LEDController.kicad_sch, outputs.kicad_sch]
2026-06-05 change prototype
2026-06-05 add relay
    [LEDController.kicad_sch, outputs.kicad_sch, power.kicad_sch]
2026-06-10 add lcsc numbers
    [outputs.kicad_sch]
2026-06-11 work on new design
    [LEDController.kicad_pcb, LEDController.kicad_sch, outputs.kicad_sch, power.kicad_sch]
2026-06-17 arrange components
    [LEDController.kicad_pcb, LEDController.kicad_sch, outputs.kicad_sch]
2026-06-18 init agents, change schematic
    [LEDController.kicad_pcb, outputs.kicad_sch]
2026-07-02 arrange components
    [LEDController.kicad_pcb, outputs.kicad_sch]
2026-07-10 add ideal diode
    [LEDController.kicad_pcb, outputs.kicad_sch, power.kicad_sch]
2026-09-11 add esd protection, pullup on EN, Replicate layout
    [LEDController.kicad_pcb, LEDController.kicad_sch, outputs.kicad_sch, power.kicad_sch]
2026-09-11 prepare tvs diodes
    [LEDController.kicad_sch, outputs.kicad_sch]
2026-09-30 add valve driver
    [LEDController.kicad_sch]
2026-10-28 cleanup kicad folder
